zhang36721/Library_Seat_Management_System/hardware/README.md

# 硬件设计资料

本目录包含项目的硬件设计相关资料。

## 目录结构

| 目录/文件 | 说明 |
|---|---|
| `wiring/` | 接线图和连接说明 |
| `datasheets/` | 元器件数据手册 |
| `module_notes/` | 模块使用说明笔记 |
| `bom/` | 物料清单 |

## 硬件版本

当前硬件版本：V1.0

## 设计文件

- 原理图：待补充
- PCB 文件：待补充
- 3D 结构图：待补充
