zhang36721/Library_Seat_Management_System/tools/README.md

# 开发工具

本目录包含开发过程中使用的工具和脚本。

## 目录结构

| 目录 | 说明 |
|---|---|
| `serial_debug/` | 串口调试工具和日志 |
| `test_data/` | 测试数据和模拟数据 |
| `scripts/` | 实用脚本 |

## 工具说明

### 串口调试
用于调试 STM32 和 ESP32S3 的串口通信。

### 测试数据
包含用于测试的模拟数据文件（CSV、JSON 等格式）。

### 实用脚本
- 数据库初始化脚本
- 数据迁移脚本
- 批量操作脚本
