zhang36721/Library_Seat_Management_System/hardware/datasheets/README.md

# 元器件数据手册

本目录存放项目中使用的元器件数据手册和技术文档。

## 待添加的数据手册

### 主控芯片
- STM32F103C8T6 数据手册
- STM32F103ZET6 数据手册（如使用）

### 无线模块
- CC2530 ZigBee 模块数据手册
- ESP32S3 数据手册

### 传感器
- 红外热释电传感器（HC-SR501）数据手册
- 压力传感器数据手册（如使用）

### 其他元器件
- USB 转 TTL 芯片（CH340/CP2102）数据手册
- 电源管理芯片（TP4056）数据手册

## 使用说明

1. 从元器件官网下载最新数据手册
2. 按元器件类型分类存放
3. 建议使用 PDF 格式
4. 可在文件名中标注版本号
