zhang36721/Library_Seat_Management_System/hardware/module_notes/README.md

# 模块使用说明笔记

本目录存放各硬件模块的使用说明和开发笔记。

## 模块笔记（待编写）

### ZigBee 模块
- CC2530 模块配置说明
- ZigBee 组网配置
- 串口透传模式设置
- 常见问题解决

### ESP32S3 模块
- WiFi 连接配置
- 串口通信设置
- 低功耗模式
- OTA 升级说明

### STM32 模块
- 开发环境搭建
- 引脚分配说明
- 低功耗配置
- 调试技巧

### 传感器模块
- 红外传感器调试
- 压力传感器校准
- 灵敏度调节

## 笔记格式建议

1. 模块基本信息（型号、厂商、购买链接）
2. 接线方式
3. 配置步骤
4. 示例代码
5. 常见问题和解决方案
6. 注意事项
