zhang36721/Library_Seat_Management_System/docs/08_sample_handover.md

# 样品交付说明

本文档用于样品交付、现场演示和最终验收前快速确认。当前阶段以稳定演示为目标，不再扩展新功能。

## 交付范围

| 部分 | 状态 | 说明 |
| --- | --- | --- |
| STM32 主控 | 可交付 | 本地刷卡、OLED、蜂鸣器、闸门控制、注册卡表 Flash 保存、ESP32 上报 |
| 座位端 STM32 | 可交付 | HX711 + 红外判断座位 1，PB8/PB7 判断座位 2/3，座位 LED 显示 |
| CC2530 ZigBee | 可交付观察 | 点对点座位状态上报，USART1 38400 |
| ESP32S3 网关 | 可交付 | WiFi、STM32 二进制协议、HTTP 主动上报 |
| 后端 | 可交付演示 | FastAPI 内存版状态和刷卡记录 |
| Web 前端 | 可交付演示 | 中文设备控制台，入口 `/library-seat/` |

## 当前关键配置

| 项目 | 当前值 |
| --- | --- |
| 后端端口 | `18080` |
| 前端开发端口 | `15173` |
| 云端入口 | `https://www.kento.top/library-seat/` |
| ESP32 上报地址 | `https://www.kento.top/library-seat/api/iot/*` |
| STM32 Debug | USART2 `115200 8N1` |
| STM32-ESP32 | USART3 `115200 8N1` |
| ZigBee | USART1 `38400 8N1` |
| ZigBee 主控模块地址 | `0x301E` |
| ZigBee 座位端模块地址 | `0x0000` |
| 主控 -> 座位端目标地址 | `0x0000`，帧地址 `00 00` |
| 座位端 -> 主控目标地址 | `0x301E`，帧地址 `1E 30` |

## 启动顺序

1. 确认后端服务运行。
2. 确认 Web 前端可访问。
3. STM32 主控上电。
4. 座位端 STM32 上电。
5. ESP32S3 上电并连接 WiFi。
6. 浏览器打开：

   ```text
   https://www.kento.top/library-seat/
   ```

## 现场验收清单

| 序号 | 验收项 | 预期结果 |
| --- | --- | --- |
| 1 | Web 打开 | 页面正常加载，后端服务正常 |
| 2 | ESP32 上电 | Web 显示 ESP32 网关在线 |
| 3 | STM32 主控上电 | Web 显示 STM32 主控在线 |
| 4 | 刷已注册卡 | OLED 显示通过，蜂鸣器短响，闸门动作，Web 出现通过记录 |
| 5 | 刷未注册卡 | OLED 显示拒绝，蜂鸣器失败提示，Web 出现拒绝记录 |
| 6 | 座位 1 状态变化 | 座位端 LED 变化，主控收到 ZigBee 更新，Web 座位状态更新 |
| 7 | 座位 2/3 电平变化 | 对应座位状态更新 |
| 8 | ESP32 断电 | Web 在离线超时后显示连接丢失 |
| 9 | ESP32 恢复 | Web 自动恢复在线 |
| 10 | 主控重启 | 注册卡表仍保留，通行记录 RAM 清空符合预期 |

## 常用调试命令

| 设备 | 命令 | 功能 |
| --- | --- | --- |
| 主控 | `FF A0 00 FF` | 打印主控业务状态 |
| 主控 | `FF A1 00 FF` | 手动刷卡测试 |
| 主控 | `FF B1 00 FF` | 打印 8 路按键原始电平 |
| 主控 | `FF C0 00 FF` | 打印本次上电 RAM 通行记录 |
| 主控 | `FF D2 00 FF` | 打印 ESP32 链路状态 |
| 主控 | `FF 84 00 FF` | 打印 ZigBee 统计和最近 RX 原始字节 |
| 主控 | `FF 85 00 FF` | 清空 ZigBee 统计 |
| 主控 | `FF 86 00 FF` | 发送 ZigBee PING |
| 主控 | `FF E0 00 FF` | 打印系统健康统计 |
| 座位端 | `FF 30 00 FF` | 打印座位传感器原始状态 |
| 座位端 | `FF 31 00 FF` | 打印座位判断结果 |
| 座位端 | `FF 80 00 FF` | 手动发送座位状态 |

## 已知限制

1. 后端和 Web 当前用于演示，后端状态以内存保存为主。
2. STM32 主控只持久化注册卡表；通行记录断电清空，最终记录以后端/云端为准。
3. ZigBee 链路依赖 CC2530 模块地址、频道、PAN ID 和供电稳定性。
4. ESP32 上传做了节流和失败冷却，网络异常时不会影响本地刷卡，但 Web 数据可能延迟。
5. 当前不做登录、用户管理、预约系统和数据库持久化。

## 交付前最后确认

| 项目 | 结果 |
| --- | --- |
| 主控 Keil Rebuild All | 待现场确认 `0 Error / 0 Warning` |
| 座位端 Keil Rebuild All | 待现场确认 `0 Error / 0 Warning` |
| ESP32 PlatformIO 编译 | 待现场确认通过 |
| 前端构建 | 待现场确认 `npm run build` 通过 |
| 后端语法检查 | 待现场确认通过 |

## 故障优先排查

1. Web 无 STM32 在线：先看 ESP32 串口是否收到 STM32 HEARTBEAT / CARD_EVENT，再看后端 `/api/iot/status`。
2. 刷卡本地正常但 Web 无记录：先看 ESP32 是否打印 `card-event POST OK`。
3. ZigBee 无座位数据：先用主控 `FF 84 00 FF` 看 `RX bytes / SEAT RX count`，再确认模块地址已对换为主控 `0x301E`、座位端 `0x0000`。
4. 主控疑似卡死：查看重启日志中的 reset reason 和 `FF E0 00 FF` 健康统计。
5. ESP32 不能访问云端：确认 `SERVER_BASE_URL_PROD` 为 `https://www.kento.top/library-seat`，并确认服务器 HTTPS 正常。
