zhang36721/Library_Seat_Management_System/hardware/bom/hardware_bom.md

# 硬件物料清单 (BOM)

## 主控芯片

| 类别 | 模块 | 数量 | 估算价格 | 用途 |
|---|---|---|---|---|
| 主控 | STM32F103C8T6 最小系统板 | 2 | 30 元 | 一个作为座位检测端，一个作为主控管理端 |

## 显示与时钟

| 类别 | 模块 | 数量 | 估算价格 | 用途 |
|---|---|---|---|---|
| 显示 | 0.96 寸 OLED IIC 屏 | 1 | 10 元 | 显示时间、座位状态、刷卡状态 |
| 时钟 | DS1302 时钟模块 | 1 | 5 元 | 提供实时时间，记录进出时间 |

## 座位检测

| 类别 | 模块 | 数量 | 估算价格 | 用途 |
|---|---|---|---|---|
| 座位检测 | 红外感应模块 + 重量压力传感器 + HX711AD | 3 | 9 元 | 检测 3 个座位是否占用 |

## 刷卡模块

| 类别 | 模块 | 数量 | 估算价格 | 用途 |
|---|---|---|---|---|
| 刷卡 | RC522 RFID 模块 | 1 | 12 元 | 识别 IC 卡 |
| 卡片 | IC 白卡 / 钥匙扣 | 5 | 10 元 | 用户刷卡介质 |

## 无线通信

| 类别 | 模块 | 数量 | 估算价格 | 用途 |
|---|---|---|---|---|
| 无线通信 | CC2530 ZigBee 串口透传模块 | 2 | 60 元 | 座位检测端与主控端无线通信 |

## WiFi 上传

| 类别 | 模块 | 数量 | 估算价格 | 用途 |
|---|---|---|---|---|
| WiFi 上传 | ESP32S3 | 1 | 25 元 | 上传数据到 Web 后端 |

## 闸机控制

| 类别 | 模块 | 数量 | 估算价格 | 用途 |
|---|---|---|---|---|
| 闸机 | 28BYJ-48 步进电机 | 1 | 8 元 | 模拟闸机开关 |
| 电机驱动 | ULN2003 驱动板 | 1 | 5 元 | 驱动步进电机 |

## 提醒与人机交互

| 类别 | 模块 | 数量 | 估算价格 | 用途 |
|---|---|---|---|---|
| 提醒 | 有源蜂鸣器模块 | 1 | 2 元 | 刷卡成功、失败、座位已满提醒 |
| 人机交互 | 独立按键模块 | 4~6 | 7 元 | 时间设置、参数调整、卡片注册/删除 |

## 调试与搭建

| 类别 | 模块 | 数量 | 估算价格 | 用途 |
|---|---|---|---|---|
| 调试 | DAPLINK 下载器 | 1 | 15 元 | STM32 下载和调试 |
| 调试 | USB 转 TTL 模块 | 1~2 | 10~20 元 | 串口调试 |
| 连接 | 杜邦线套装 | 1 | 25 元 | 模块连接 |
| 搭建 | 面包板 / 洞洞板 | 1 | 26 元 | 硬件搭建 |

## 总计

| 类别 | 总价 |
|---|---|
| 硬件总费用 | 约 259~269 元 |

## 备注

1. 价格为市场参考价，实际采购可能有所浮动
2. 独立按键模块数量根据实际需求调整（4~6 个）
3. USB 转 TTL 模块可根据已有设备调整数量
