zhang36721/Library_Seat_Management_System/hardware/wiring/main_controller_wiring.md

# STM32 主控接线图

本表用于 v1.3 演示和复查接线。主控调试串口固定为 USART2，ZigBee 固定为 USART1，ESP32S3 固定为 USART3，三者不要混用。

| 模块 | 功能 | 模块引脚 | MCU 引脚 | 方向 | 电平 | 默认状态 | 备注 |
| --- | --- | --- | --- | --- | --- | --- | --- |
| Debug 串口 | USART2_TX | RXD | PA2 | MCU -> 模块 | 3.3V TTL, 115200 8N1 | 空闲高 | `FF CMD DATA FF` 调试协议 |
| Debug 串口 | USART2_RX | TXD | PA3 | 模块 -> MCU | 3.3V TTL, 115200 8N1 | 空闲高 | ESP32/ZigBee 不允许占用 USART2 |
| ESP32S3 | USART3_TX | GPIO48 UART_RX | PB10 | MCU -> ESP32 | 3.3V TTL, 115200 8N1 | 空闲高 | TX/RX 交叉，ESP32 侧 GPIO48 可能与板载 RGB LED 冲突 |
| ESP32S3 | USART3_RX | GPIO47 UART_TX | PB11 | ESP32 -> MCU | 3.3V TTL, 115200 8N1 | 空闲高 | 必须共地 |
| ZigBee CC2530 | USART1_TX | P1.7 RX | PA9 | MCU -> ZigBee | 3.3V TTL, 38400 8N1 | 空闲高 | 二进制帧 `FA ADDR_L ADDR_H LEN DATA F5` |
| ZigBee CC2530 | USART1_RX | P1.6 TX | PA10 | ZigBee -> MCU | 3.3V TTL, 38400 8N1 | 空闲高 | 主控模块已换为短地址 `0x301E`，座位端模块 `0x0000` |
| ZigBee CC2530 | 唤醒 | P2.0 | GND | 固定 | 低电平保持唤醒 | 唤醒 | VCC 只能接 3.3V |
| RC522 | SPI SCK | SCK | PA5 | MCU -> RC522 | 3.3V | 空闲低/按驱动 | 已实测可读 UID |
| RC522 | SPI MISO | MISO | PA6 | RC522 -> MCU | 3.3V | 输入 | 已实测可读 UID |
| RC522 | SPI MOSI | MOSI | PA7 | MCU -> RC522 | 3.3V | 空闲 | 已实测可读 UID |
| RC522 | 片选 | SDA/NSS | PB12 | MCU -> RC522 | 低有效 | 高电平未选中 | 不再占用 PA4 |
| RC522 | 复位 | RST | PB13 | MCU -> RC522 | 高有效 | 高电平 | 上电初始化探测版本寄存器 |
| OLED | I2C SCL | SCL | PB6 | MCU -> OLED | 3.3V I2C | 上拉高 | 与 OLED 驱动一致 |
| OLED | I2C SDA | SDA | PB7 | 双向 | 3.3V I2C | 上拉高 | 显示首页、刷卡、菜单 |
| DS1302 | 时钟 | CLK | PB0 | MCU -> DS1302 | 3.3V | 低 | 已支持读写时间和校准 |
| DS1302 | 数据 | DAT | PB1 | 双向 | 3.3V | 输入/输出切换 | 时间非法会告警 |
| DS1302 | 复位/使能 | RST | PB5 | MCU -> DS1302 | 高有效 | 低 | 写入前关闭写保护 |
| 蜂鸣器 | 提示音 | SIG | PA4 | MCU -> 模块 | 依实测有效电平 | 关闭 | 上电默认关闭，成功/失败非阻塞提示 |
| 运行 LED | 系统/ESP32链路指示 | LED | PC13 | MCU -> LED | 低电平点亮 | 高电平关闭 | 普通心跳关闭，保留 ESP32 链路闪灯 |
| 8 键模块 | K1 MENU | K1 | PA1 | 模块 -> MCU | 输入上拉，低有效 | 松开高 | 短按进菜单，长按返回 |
| 8 键模块 | K2 UP | K2 | PA8 | 模块 -> MCU | 输入上拉，低有效 | 松开高 | 菜单上移/数值加 |
| 8 键模块 | K3 DOWN | K3 | PA11 | 模块 -> MCU | 输入上拉，低有效 | 松开高 | 菜单下移/数值减 |
| 8 键模块 | K4 LEFT | K4 | PA12 | 模块 -> MCU | 输入上拉，低有效 | 松开高 | 上一个字段 |
| 8 键模块 | K5 RIGHT | K5 | PA15 | 模块 -> MCU | 输入上拉，低有效 | 松开高 | 需关闭 JTAG，保留 SWD |
| 8 键模块 | K6 OK | K6 | PB3 | 模块 -> MCU | 输入上拉，低有效 | 松开高 | 需关闭 JTAG，保留 SWD |
| 8 键模块 | K7 CARD ADD | K7 | PB4 | 模块 -> MCU | 输入上拉，低有效 | 松开高 | 需关闭 JTAG，保留 SWD |
| 8 键模块 | K8 CARD DEL | K8 | PC14 | 模块 -> MCU | 输入上拉，低有效 | 松开高 | 若 PC14 被晶振占用，改 PC15 |
| ULN2003 | 步进 IN1 | IN1 | PB8 | MCU -> 驱动 | 高有效 | 低，线圈关闭 | 闸门开关流程结束后必须 STOP |
| ULN2003 | 步进 IN2 | IN2 | PB9 | MCU -> 驱动 | 高有效 | 低，线圈关闭 | 电机供电与 MCU 共地 |
| ULN2003 | 步进 IN3 | IN3 | PB14 | MCU -> 驱动 | 高有效 | 低，线圈关闭 | 电机动作非阻塞 |
| ULN2003 | 步进 IN4 | IN4 | PB15 | MCU -> 驱动 | 高有效 | 低，线圈关闭 | 电机动作非阻塞 |
| 电源 | 主控供电 | 3.3V / 5V | 板载电源 | 输入 | 按模块要求 | 稳定供电 | RC522/ZigBee/ESP32 信号侧必须 3.3V |
| 共地 | 公共参考地 | GND | GND | 双向 | 0V | 共地 | STM32、ESP32、ZigBee、外设必须共地 |

我现在有：
1：微动轻触开关三脚（做防拆）
2：AT24C16模块（用于记录：最近的测试：时间+0 1（失败、成功）以及防拆锁定标志位倒数第一页 以及基础项目信息（倒数第二页））
3：华深科呼出酒精检测传感器模组0-500（串口通信9600 8n1）
4：RGB全彩10mmLED模块(做灯效)
5：STM32F103C8T6模块
6：防反接二极管（若干）
7：3.6*10mm玻璃保险管1A（若干）
8：5KP24A （若干）
9：小头款-圆线直头公头开口线30厘米（做外壳的时候固定接口）
10：OBD2延长线车载电脑加长线转换插头公对母扁线16针16芯全部通电（做车辆到外壳的链接线）
11：自复位开关3-6V;19MM（用于做手动开始酒精检测流程，替代红外和重力模块的检测）
12：0.96寸蓝色 1315驱动 （显示一些信息）
13：【配12V1A电源头】+大电流5V3.3V12V（供电模块，用于未接入车辆时的供电）
14：1路继电器 5VDC
15：CMSIS-DAP仿真器
16：2W喇嘛模块一个（用于语音播报）
17：Type-C母座转TTL模块（用于下串口指令来做一些命令，如管理员接触锁定、开启防拆功能）

这是我暂时拥有的基础设施，开发我的酒精检测车辆控制系统使用；
1：请问我的设计是否合理？
2：mcu引脚资源是否够用？
3：还缺少什么模块？
4：对项目进行可行性分析
