zhang36721/Library_Seat_Management_System/hardware/wiring/seat_node_wiring.md

# 座位端 STM32 接线图

座位端负责采集 3 个座位状态，并通过 CC2530 ZigBee 二进制帧发送给主控。USART2 只作为座位端 debug。

| 模块 | 功能 | 模块引脚 | MCU 引脚 | 方向 | 电平 | 默认状态 | 备注 |
| --- | --- | --- | --- | --- | --- | --- | --- |
| Debug 串口 | USART2_TX | RXD | PA2 | MCU -> 调试器 | 3.3V TTL, 115200 8N1 | 空闲高 | `FF CMD DATA FF` |
| Debug 串口 | USART2_RX | TXD | PA3 | 调试器 -> MCU | 3.3V TTL, 115200 8N1 | 空闲高 | 不接 ZigBee |
| ZigBee CC2530 | USART1_TX | P1.7 RX | PA9 | MCU -> ZigBee | 3.3V TTL, 38400 8N1 | 空闲高 | 发送给主控地址 `0x301E` |
| ZigBee CC2530 | USART1_RX | P1.6 TX | PA10 | ZigBee -> MCU | 3.3V TTL, 38400 8N1 | 空闲高 | 座位端模块已换为短地址 `0x0000` |
| ZigBee CC2530 | 唤醒 | P2.0 | GND | 固定 | 低电平保持唤醒 | 唤醒 | VCC 只能接 3.3V |
| HX711 | 数据 | DT | PA4 | HX711 -> MCU | 3.3V | 输入 | 座位 1 重力检测，ready 等待有超时 |
| HX711 | 时钟 | SCK | PA5 | MCU -> HX711 | 3.3V | 低 | 未 ready 返回 UNKNOWN，不阻塞主循环 |
| 压力传感器 | 电桥正激励 | E+ | 传感器红线 | 输出 | 模块供电 | 按模块 | 按 HX711 模块丝印接线 |
| 压力传感器 | 电桥负激励 | E- | 传感器黑线 | 输出 | GND | 按模块 | 按 HX711 模块丝印接线 |
| 压力传感器 | 信号正 | A+ | 传感器绿线 | 输入 | 模拟差分 | 按模块 | 以实物线色为准 |
| 压力传感器 | 信号负 | A- | 传感器白线 | 输入 | 模拟差分 | 按模块 | 以实物线色为准 |
| 红外检测 | 座位 1 辅助检测 | OUT | PB9 | 模块 -> MCU | 高有效 | 输入 | 座位 1 = 重量 > 50g 且红外检测到 |
| 座位 2 检测 | 高电平占用 | OUT | PB8 | 模块 -> MCU | 高有效 | 输入 | 不使用红外 |
| 座位 3 检测 | 高电平占用 | OUT | PB7 | 模块 -> MCU | 高有效 | 输入 | 不使用红外 |
| 座位 1 LED | 红灯 | R | PB5 | MCU -> LED | 高有效 | 关闭 | 占用亮红，空闲灭红 |
| 座位 1 LED | 绿灯 | G | PB6 | MCU -> LED | 高有效 | 关闭 | 空闲亮绿，占用灭绿 |
| 座位 2 LED | 红灯 | R | PB3 | MCU -> LED | 高有效 | 关闭 | 需关闭 JTAG，保留 SWD |
| 座位 2 LED | 绿灯 | G | PB4 | MCU -> LED | 高有效 | 关闭 | 需关闭 JTAG，保留 SWD |
| 座位 3 LED | 红灯 | R | PA12 | MCU -> LED | 高有效 | 关闭 | 占用亮红，空闲灭红 |
| 座位 3 LED | 绿灯 | G | PA15 | MCU -> LED | 高有效 | 关闭 | 需关闭 JTAG，保留 SWD |
| 指示灯 | 红外检测 | LED | PB14 | MCU -> LED | 高有效 | 关闭 | 红外检测到时点亮 |
| 指示灯 | 重量阈值 | LED | PB15 | MCU -> LED | 高有效 | 关闭 | HX711 重量超过阈值时点亮 |
| 运行 LED | 座位端状态 | LED | PC13 | MCU -> LED | 低电平点亮 | 高电平关闭 | 上电默认关闭 |
| 电源 | 模块供电 | VCC | 3.3V | 输入 | 3.3V | 稳定供电 | ZigBee/HX711/传感器建议 3.3V |
| 共地 | 公共参考地 | GND | GND | 双向 | 0V | 共地 | 座位端、ZigBee、传感器必须共地 |
