zhang36721/Library_Seat_Management_System/firmware/main_controller_stm32/Core/Src/main.c

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
/* Includes ------------------------------------------------------------------*/
#include "main.h"
#include "usart.h"
#include "gpio.h"
#include <stdio.h>

/* USER CODE BEGIN Includes */
#include "kt_debug.h"
#include "kt_config.h"
#include "kt_port_uart.h"
#include "kt_port_gpio.h"
#include "kt_task/kt_task.h"
#include "kt_app/app_io.h"
#include "kt_app/main_keys.h"
#include "kt_app/main_controller_app.h"
#include "kt_system/kt_boot_count.h"
#include "kt_system/kt_system_health.h"
#include "kt_system/kt_watchdog.h"
#include "kt_modules/kt_modules.h"
#include "kt_modules/kt_uart_links.h"
#include "kt_modules/kt_esp32_link.h"
#include "kt_zigbee/kt_zigbee.h"
/* USER CODE END Includes */


void SystemClock_Config(void);
/* USER CODE BEGIN PFP */
#if APP_HEARTBEAT_LED_ENABLE
static void app_heartbeat_task(void);
#endif
#if KT_ENABLE_UPTIME_LOG
static void app_status_task(void);
#endif
/* USER CODE END PFP */

/* USER CODE BEGIN 0 */

/**
 * @brief  Heartbeat task — toggle PC13 LED every 500ms
 */
#if APP_HEARTBEAT_LED_ENABLE
static void app_heartbeat_task(void)
{
    kt_led_toggle(&app_led);
}
#endif

/**
 * @brief  Status task — print uptime every 3000ms
 */
#if KT_ENABLE_UPTIME_LOG
static void app_status_task(void)
{
    static uint32_t last_print_ms = 0;
    char buf[64];
    uint32_t uptime_s = HAL_GetTick() / 1000;

    kt_port_uart_tx_string("[LOG] Uptime: ");
    snprintf(buf, sizeof(buf), "%lu s\r\n", (unsigned long)uptime_s);
    kt_port_uart_tx_string(buf);
}
#endif

/* USER CODE END 0 */

/**
  * @brief  The application entry point.
  * @retval int
  */
int main(void)
{

  /* MCU Configuration--------------------------------------------------------*/

  /* Reset of all peripherals, Initializes the Flash interface and the Systick. */
  HAL_Init();

  /* Configure the system clock */
  SystemClock_Config();

  /* Initialize all configured peripherals */
  MX_GPIO_Init();
  MX_USART1_UART_Init();
  MX_USART2_UART_Init();
  MX_USART3_UART_Init();
  /* USER CODE BEGIN 2 */
  kt_system_health_init();
  kt_boot_count_init();
  kt_debug_init();
  kt_debug_print_system_info();
  kt_system_health_print_reset_reason();
  kt_watchdog_init();
  kt_port_uart_start_receive_it();
  kt_modules_init();

  /* v1.0: App I/O initialization (LED, Button, Buzzer - multi-instance) */
  app_io_init();
  main_keys_init();
  main_controller_app_init();
  kt_led_off(&app_led);  /* Ensure LED starts off */

  /* v1.0: Task scheduler - includes device & app tasks */
  kt_task_init();
  kt_task_register("debug",     kt_debug_task,       1);
  kt_task_register("app_io",    app_io_tasks,       10);   /* LED blink + button debounce + buzzer */
  kt_task_register("main_keys", main_keys_task,     10);
  kt_task_register("main_app",  main_controller_app_task, MAIN_APP_TASK_PERIOD_MS);
#if APP_HEARTBEAT_LED_ENABLE
  kt_task_register("heartbeat", app_heartbeat_task, 500);
#endif
#if KT_ENABLE_UPTIME_LOG
  kt_task_register("status",    app_status_task,    3000);
#endif
  /* USER CODE END 2 */

  /* Infinite loop */
  /* USER CODE BEGIN WHILE */
  while (1)
  {
    /* USER CODE END WHILE */

    /* USER CODE BEGIN 3 */
    kt_task_run();
    kt_modules_task();
    kt_system_health_note_main_loop();
    kt_watchdog_task();
  }
  /* USER CODE END 3 */
}

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
/* USER CODE BEGIN 4 */

/**
  * @brief  UART RX complete callback
  * @param  huart  UART handle
  * @retval None
  */
void HAL_UART_RxCpltCallback(UART_HandleTypeDef *huart)
{
    kt_zigbee_uart_rx_callback(huart);
    kt_esp32_link_uart_rx_callback(huart);
    kt_port_uart_rx_callback(huart);
}

void HAL_UART_TxCpltCallback(UART_HandleTypeDef *huart)
{
    kt_zigbee_tx_callback(huart);
    kt_esp32_link_uart_tx_callback(huart);
    kt_port_uart_tx_callback(huart);
}

/* USER CODE END 4 */
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
