zhang36721/Library_Seat_Management_System/firmware/main_controller_stm32/ktlib/kt_port/kt_port_uart.c

#include "kt_port_uart.h"
#include "kt_config.h"
#include <string.h>

/* Ring buffer backing storage: 256 bytes (255 usable) */
#define KT_UART_RX_RING_SIZE  256
#define KT_UART_TX_RING_SIZE  1024
static uint8_t kt_uart_rx_ring_buf[KT_UART_RX_RING_SIZE];
static uint8_t kt_uart_tx_ring_buf[KT_UART_TX_RING_SIZE];

/* Single-byte receive buffer for UART2 interrupt reception */
volatile uint8_t kt_uart_rx_byte = 0;

/* Ring buffer instance (public for upper layers that need direct access) */
kt_ringbuf_t kt_uart_rx_ring;

/* Overflow counter - incremented in ISR when ring buffer is full */
static volatile uint32_t kt_uart_rx_overflow_cnt = 0;
static volatile uint16_t kt_uart_tx_head = 0U;
static volatile uint16_t kt_uart_tx_tail = 0U;
static volatile uint8_t kt_uart_tx_busy = 0U;
static volatile uint32_t kt_uart_tx_drop_cnt = 0U;
static uint8_t kt_uart_tx_active_byte;

static uint16_t tx_next(uint16_t value)
{
    value++;
    if (value >= KT_UART_TX_RING_SIZE) {
        value = 0U;
    }
    return value;
}

static void kt_port_uart_tx_kick(void)
{
    uint16_t tail;

    if (kt_uart_tx_busy != 0U || kt_uart_tx_head == kt_uart_tx_tail) {
        return;
    }

    tail = kt_uart_tx_tail;
    kt_uart_tx_active_byte = kt_uart_tx_ring_buf[tail];
    kt_uart_tx_tail = tx_next(tail);
    kt_uart_tx_busy = 1U;
    if (HAL_UART_Transmit_IT(&huart2, &kt_uart_tx_active_byte, 1U) != HAL_OK) {
        kt_uart_tx_busy = 0U;
        kt_uart_tx_drop_cnt++;
    }
}

static uint8_t kt_port_uart_tx_enqueue(uint8_t byte)
{
    uint16_t next;

    __disable_irq();
    next = tx_next(kt_uart_tx_head);
    if (next == kt_uart_tx_tail) {
        kt_uart_tx_drop_cnt++;
        __enable_irq();
        return 0U;
    }

    kt_uart_tx_ring_buf[kt_uart_tx_head] = byte;
    kt_uart_tx_head = next;
    __enable_irq();
    return 1U;
}

/**
 * @brief Queue a single byte over USART2
 */
void kt_port_uart_tx_byte(uint8_t byte)
{
    (void)kt_port_uart_tx_enqueue(byte);
    kt_port_uart_tx_kick();
}

/**
 * @brief Transmit a string over USART2 (finite timeout)
 * @return HAL_OK on success, error code otherwise
 */
int kt_port_uart_tx_string(const char *str)
{
    size_t len;
    size_t i;
    uint8_t ok = 1U;

    if (str == NULL) {
        return HAL_ERROR;
    }

    len = strlen(str);
    if (len == 0) {
        return HAL_OK;
    }

    for (i = 0U; i < len; i++) {
        if (kt_port_uart_tx_enqueue((uint8_t)str[i]) == 0U) {
            ok = 0U;
        }
    }
    kt_port_uart_tx_kick();
    return ok ? HAL_OK : HAL_BUSY;
}

/**
 * @brief Start UART2 interrupt reception for a single byte
 *
 *        Must be called once after UART init.  The ISR will re-arm itself
 *        after every received byte.
 */
void kt_port_uart_start_receive_it(void)
{
    /* Initialize the ring buffer before starting reception */
    kt_ringbuf_init(&kt_uart_rx_ring, kt_uart_rx_ring_buf, KT_UART_RX_RING_SIZE);

    kt_uart_rx_overflow_cnt = 0;
    kt_uart_tx_head = 0U;
    kt_uart_tx_tail = 0U;
    kt_uart_tx_busy = 0U;
    kt_uart_tx_drop_cnt = 0U;

    HAL_UART_Receive_IT(&huart2, (uint8_t *)&kt_uart_rx_byte, 1);
}

/**
 * @brief ISR callback: ONLY writes byte to ring buffer and re-arms
 *
 *        This function must be called from HAL_UART_RxCpltCallback
 *        when huart->Instance == USART2.
 *
 *        It does NOT:
 *          - Parse any protocol
 *          - Call any business-logic callbacks
 *          - Perform blocking operations
 *          - Call any logging (KT_LOG_* not ISR-safe)
 *
 *        If the ring buffer is full, the byte is silently dropped and
 *        the overflow counter is incremented.
 */
void kt_port_uart_rx_callback(UART_HandleTypeDef *huart)
{
    if (huart->Instance == USART2) {
        /* ISR: only push to ring buffer; track overflow */
        if (kt_ringbuf_put(&kt_uart_rx_ring, kt_uart_rx_byte) != 0) {
            kt_uart_rx_overflow_cnt++;
            /* Byte dropped — no ISR-safe logging, just count */
        }

        /* Re-arm interrupt for next byte */
        HAL_UART_Receive_IT(&huart2, (uint8_t *)&kt_uart_rx_byte, 1);
    }
}

/**
 * @brief Get number of bytes available for reading from the RX ring buffer
 */
uint16_t kt_port_uart_rx_available(void)
{
    return kt_ringbuf_available(&kt_uart_rx_ring);
}

/**
 * @brief Read one byte from the RX ring buffer (main loop context)
 * @return 0 on success, -1 if buffer is empty
 */
int kt_port_uart_rx_read(uint8_t *byte)
{
    return kt_ringbuf_get(&kt_uart_rx_ring, byte);
}

/**
 * @brief Get RX overflow count (incremented when ring buffer is full in ISR)
 * @return Number of bytes lost due to ring buffer full
 */
uint32_t kt_port_uart_rx_overflow_count(void)
{
    /* Safe read of volatile counter from main loop context */
    return kt_uart_rx_overflow_cnt;
}

void kt_port_uart_tx_callback(UART_HandleTypeDef *huart)
{
    if (huart->Instance == USART2) {
        kt_uart_tx_busy = 0U;
        kt_port_uart_tx_kick();
    }
}
