zhang36721/Library_Seat_Management_System/firmware/seat_node_stm32/ktlib/kt_app/seat_node_app.h

#ifndef SEAT_NODE_APP_H
#define SEAT_NODE_APP_H

#include "stm32f1xx_hal.h"

#ifdef __cplusplus
extern "C" {
#endif

void seat_node_app_init(void);
void seat_node_app_task(void);
void seat_node_print_hardware_status(void);
void seat_node_print_uart_roles(void);
void seat_node_print_raw_levels(void);
void seat_node_print_status(void);
void seat_node_print_led_map(void);
void seat_node_refresh_and_print_leds(void);
void seat_node_tare_hx711(void);
void seat_node_calibrate_hx711(uint8_t units_10g);
void seat_node_print_hx711_weight(void);
void seat_node_send_zigbee_status(void);
void seat_node_send_zigbee_pong(void);
void seat_node_print_zigbee_info(void);
void seat_node_zigbee_rx_callback(UART_HandleTypeDef *huart);

#ifdef __cplusplus
}
#endif

#endif /* SEAT_NODE_APP_H */
