zhang36721/Library_Seat_Management_System/firmware/main_controller_stm32/ktlib/kt_modules/kt_ds1302.h

#ifndef KT_DS1302_H
#define KT_DS1302_H

#include <stdint.h>

#ifdef __cplusplus
extern "C" {
#endif

typedef struct
{
    uint8_t year;
    uint8_t month;
    uint8_t day;
    uint8_t hour;
    uint8_t minute;
    uint8_t second;
} kt_ds1302_time_t;

void kt_ds1302_write_test_time(void);
uint8_t kt_ds1302_set_time(const kt_ds1302_time_t *time);
void kt_ds1302_read_time(kt_ds1302_time_t *time);
uint8_t kt_ds1302_time_is_valid(const kt_ds1302_time_t *time);
uint8_t kt_ds1302_init_check(void);
void kt_ds1302_print_time(void);

#ifdef __cplusplus
}
#endif

#endif /* KT_DS1302_H */
