zhang36721/Library_Seat_Management_System/firmware/main_controller_stm32/ktlib/kt_system/kt_boot_count.h

#ifndef KT_BOOT_COUNT_H
#define KT_BOOT_COUNT_H

#include <stdint.h>

#ifdef __cplusplus
extern "C" {
#endif

void kt_boot_count_init(void);
uint32_t kt_boot_count_get(void);

#ifdef __cplusplus
}
#endif

#endif /* KT_BOOT_COUNT_H */
