zhang36721/Library_Seat_Management_System/(commit log)

2026-04-27 修正项目基础文档和 Git 忽略规则
2026-04-27 调整项目为 JSON 数据表存储方案
2026-04-27 修正项目硬件结构和文档范围
2026-04-28 加入stm32 demo代码以debug sys init
2026-04-28 修复库文件的一些bug
2026-04-28 优化库健壮性
2026-04-28 优化库文件
2026-04-28 docs: add hardware wiring plan
2026-04-28 firmware: add seat node zigbee sensor baseline
2026-04-29 firmware: add main local card flow
2026-04-29 firmware: add ds1302 debug time calibration
2026-04-29 主控端开发以及基础esp32端开发
2026-04-29 添加前后端代码
2026-04-29 feat: simplify frontend UI - HomeView/LoginView/RecordsView, remove devices/system, fix login (admin/admin123), make logs public
2026-04-29 chore: remove devices/system APIs from backend router, delete corresponding frontend files
2026-05-07 fix: improve controller link stability and key responsiveness
    [kt_config.h, kt_esp32_link.c, main.c, main_controller_app.c, stm32_link.cpp]
2026-05-07 fix: add controller watchdog and stabilize STM32 online status
    [kt_config.h, kt_system_health.c, kt_system_health.h, kt_watchdog.c, main.c, stm32_link.cpp]
2026-05-07 fix: disable automatic gate motor drive for watchdog stability
    [kt_config.h]
2026-05-07 fix: stabilize card flow watchdog path
    [kt_config.h, kt_esp32_link.c, main_controller_app.c]
2026-05-07 fix: reduce card flow stack pressure and repeat polling
    [kt_esp32_link.c, main_controller_app.c]
2026-05-07 fix: send ESP32 UART frames asynchronously
    [kt_esp32_link.c, kt_esp32_link.h, main.c]
2026-05-07 fix: simplify gateway and zigbee link handling
    [kt_config.h, kt_esp32_link.c, kt_system_health.c, kt_uart_links.c, stm32_link.cpp]
2026-05-07 fix: clarify ESP32 push link status
    [kt_esp32_link.c]
2026-05-07 fix: simplify live links for stable demo
    [kt_config.h, kt_esp32_link.c, kt_uart_links.c, seat_node_app.c, stm32_link.cpp]
2026-05-08 chore: prepare sample handover
