zhang36721/Library_Seat_Management_System/(notices)

Notices in the files:
firmware/main_controller_stm32/Core/Src/main.c:
Copyright (c) 2026 STMicroelectronics.
All rights reserved.
This software is licensed under terms that can be found in the LICENSE file
